build-week/hover-jet/vision/fiducial_board.png

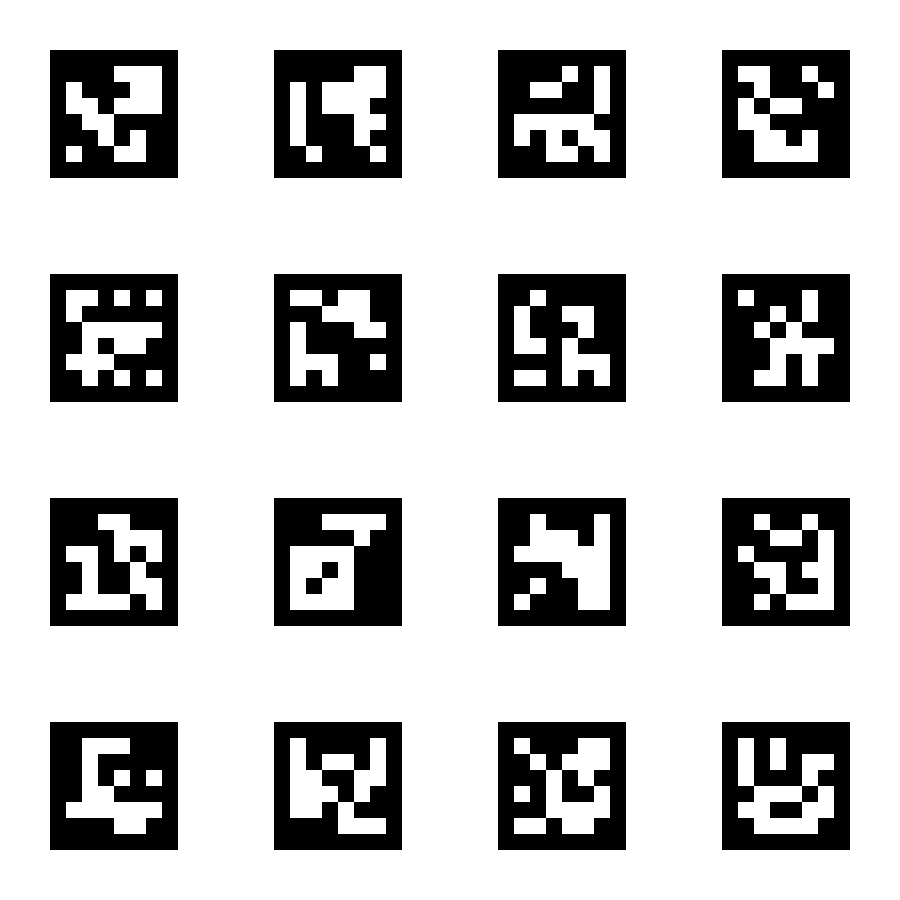
vision/fiducial_board.png
