build-week/hover-jet/hardware/schematics/hoverjet1.5/current_sensor.kicad_sch

## KiCad design hardware/schematics/hoverjet1.5/current_sensor.kicad_sch (2024-02-24)

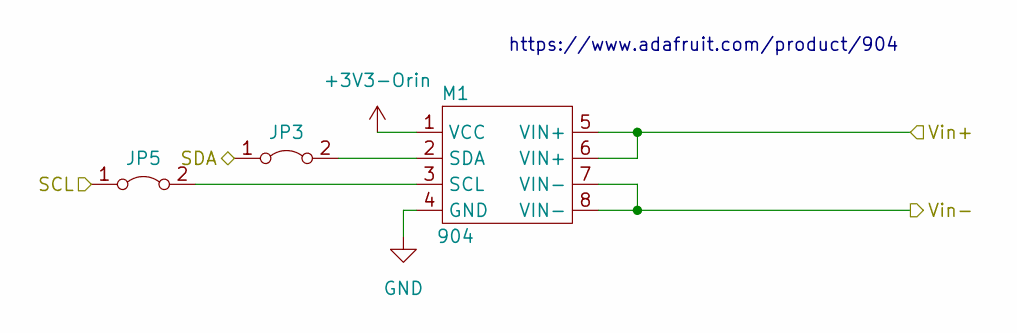
[picture p3: schematic current_sensor.kicad_sch]

Parts:
JP3, JP5: Jumper_2_Bridged; SolderJumper-2_P1.3mm_Bridged_Pad1.0x1.5mm
M1: 904; Manufacturer Part Number 904

Connections:
+3V3-Orin: M1.1 (VCC)
GND: M1.4 (GND)
unnamed: JP3.2 (B), M1.2 (SDA)
unnamed: JP5.2 (B), M1.3 (SCL)
SCL: JP5.1 (A)
SDA: JP3.1 (A)
Vin+: M1.5 (VIN+), M1.6 (VIN+)
Vin-: M1.7 (VIN-), M1.8 (VIN-)

Notes on the sheet:
https://www.adafruit.com/product/904
