build-week/hover-jet/hardware/schematics/hoverjet1.5/hoverjet1.5.kicad_sch

## KiCad design hardware/schematics/hoverjet1.5/hoverjet1.5.kicad_sch (2024-02-24)

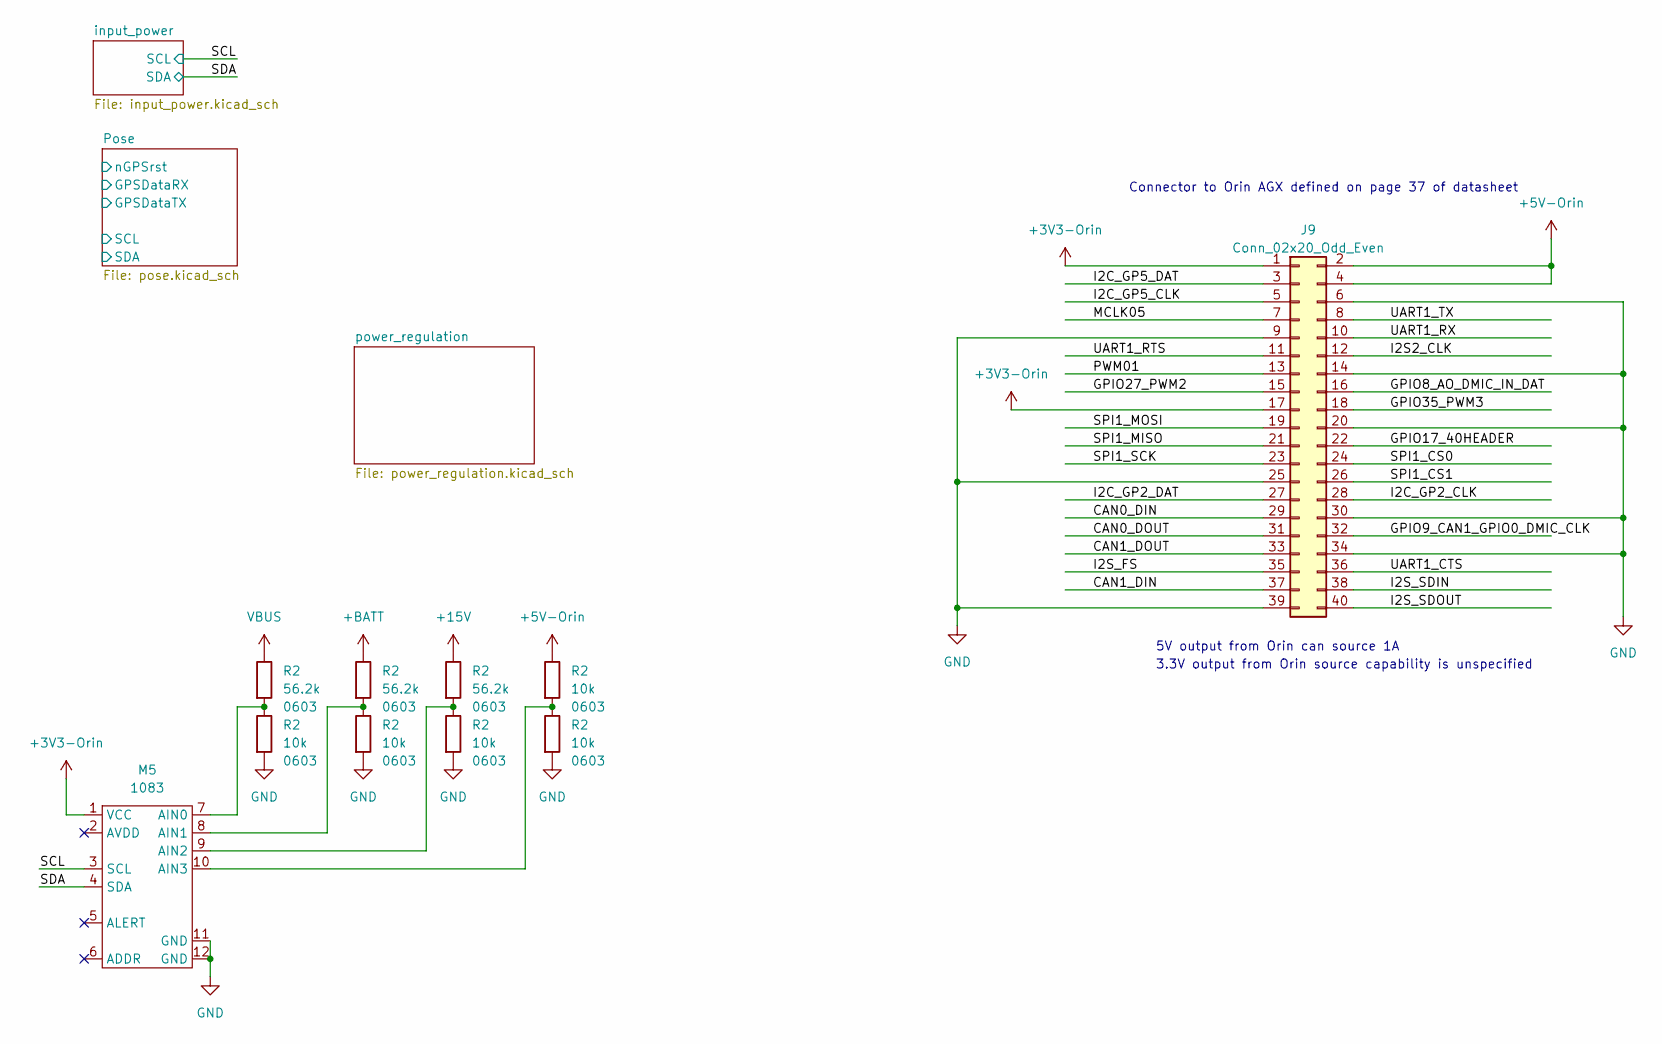
[picture p4: schematic hoverjet1.5.kicad_sch]

Parts:
J9: Conn_02x20_Odd_Even; PinHeader_2x20_P2.54mm_Horizontal
M5: 1083; MPN 1083
R2: 10k; R_0603_1608Metric_Pad0.98x0.95mm_HandSolder; Tolerance 1%; MPN RMCF0603FT10K0

Connections:
+3V3-Orin: J9.1, J9.17, M5.1 (VCC)
+5V-Orin: J9.2, J9.4, R2.1
+15V: R2.1
+BATT: R2.1
CAN0_DIN: J9.29
CAN0_DOUT: J9.31
CAN1_DIN: J9.37
CAN1_DOUT: J9.33
GND: J9.6, J9.9, J9.14, J9.20, J9.25, J9.30, J9.34, J9.39, M5.11 (GND), M5.12 (GND), R2.2
GPIO8_AO_DMIC_IN_DAT: J9.16
GPIO9_CAN1_GPIO0_DMIC_CLK: J9.32
GPIO17_40HEADER: J9.22
GPIO27_PWM2: J9.15
GPIO35_PWM3: J9.18
I2C_GP2_CLK: J9.28
I2C_GP2_DAT: J9.27
I2C_GP5_CLK: J9.5
I2C_GP5_DAT: J9.3
I2S2_CLK: J9.12
I2S_FS: J9.35
I2S_SDIN: J9.38
I2S_SDOUT: J9.40
MCLK05: J9.7
unnamed: M5.7 (AIN0), R2.1, R2.2
unnamed: M5.8 (AIN1), R2.1, R2.2
unnamed: M5.9 (AIN2), R2.1, R2.2
unnamed: M5.10 (AIN3), R2.1, R2.2
PWM01: J9.13
SCL: M5.3 (SCL)
SDA: M5.4 (SDA)
SPI1_CS0: J9.24
SPI1_CS1: J9.26
SPI1_MISO: J9.21
SPI1_MOSI: J9.19
SPI1_SCK: J9.23
UART1_CTS: J9.36
UART1_RTS: J9.11
UART1_RX: J9.10
UART1_TX: J9.8
VBUS: R2.1

Notes on the sheet:
3.3V output from Orin source capability is unspecified
Connector to Orin AGX defined on page 37 of datasheet
5V output from Orin can source 1A
