build-week/hover-jet/hardware/schematics/hoverjet1.5/input_power.kicad_sch

## KiCad design hardware/schematics/hoverjet1.5/input_power.kicad_sch (2023-09-26)

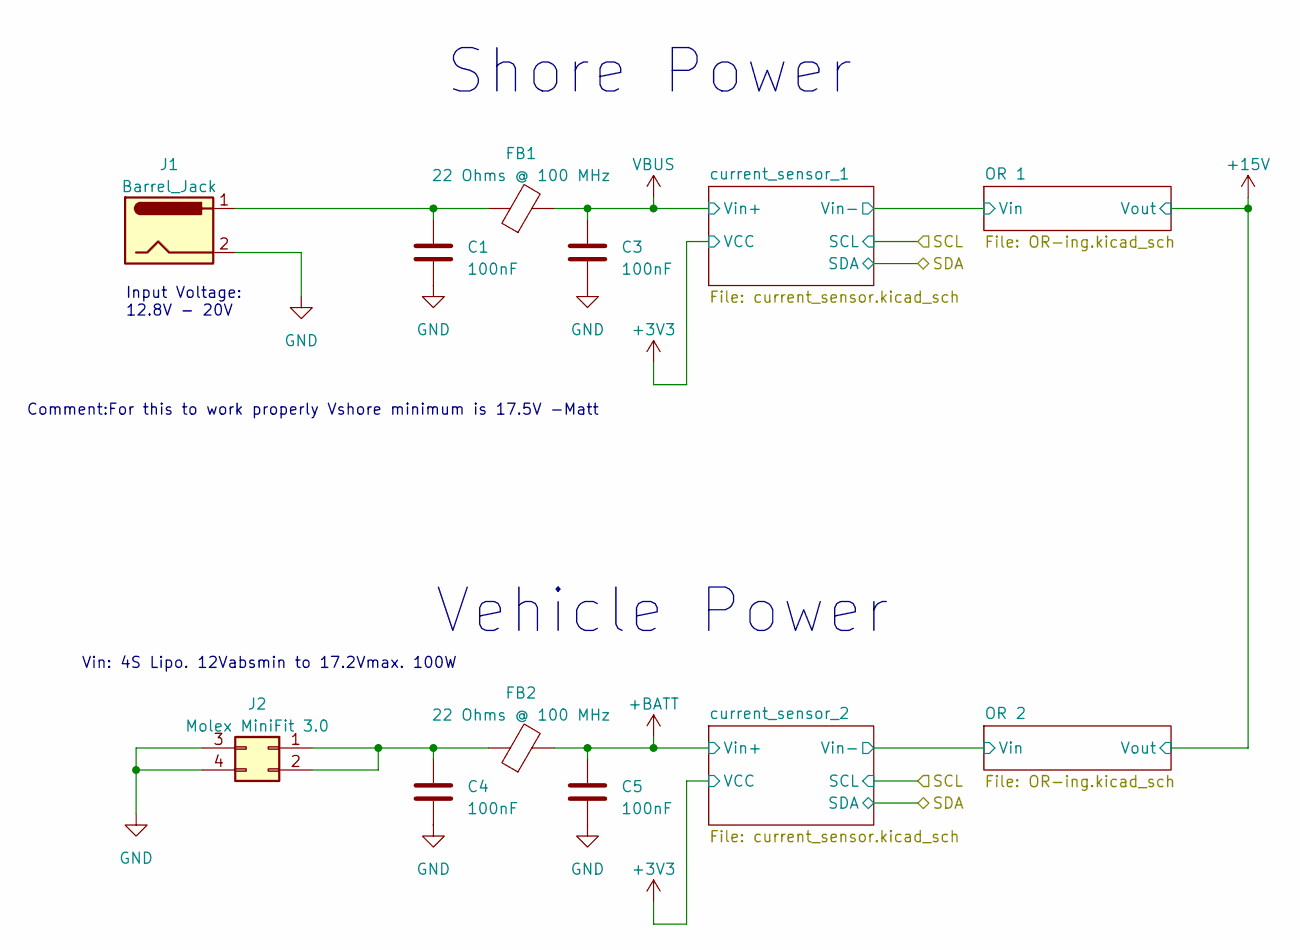
[picture p5: schematic input_power.kicad_sch]

Parts:
C1, C3, C4, C5: 100nF; C_0201_0603Metric
FB1, FB2: 22 Ohms @ 100 MHz; R_0805_2012Metric
J1: Barrel_Jack; BarrelJack_CUI_PJ-063AH_Horizontal
J2: Molex MiniFit 3.0; Molex_Micro-Fit_3.0_43045-0400_2x02_P3.00mm_Horizontal

Connections:
+BATT: C5.1, FB2.2
GND: C1.2, C3.2, C4.2, C5.2, J1.2, J2.3, J2.4
unnamed: C1.1, FB1.1, J1.1
unnamed: C4.1, FB2.1, J2.1, J2.2
VBUS: C3.1, FB1.2

Notes on the sheet:
Input Voltage: 12.8V - 20V
Shore Power
Vehicle Power
Vin: 4S Lipo. 12Vabsmin to 17.2Vmax. 100W
Comment:For this to work properly Vshore minimum is 17.5V -Matt
