build-week/hover-jet/hardware/schematics/hoverjet1.5/pose.kicad_sch

## KiCad design hardware/schematics/hoverjet1.5/pose.kicad_sch (2024-02-24)

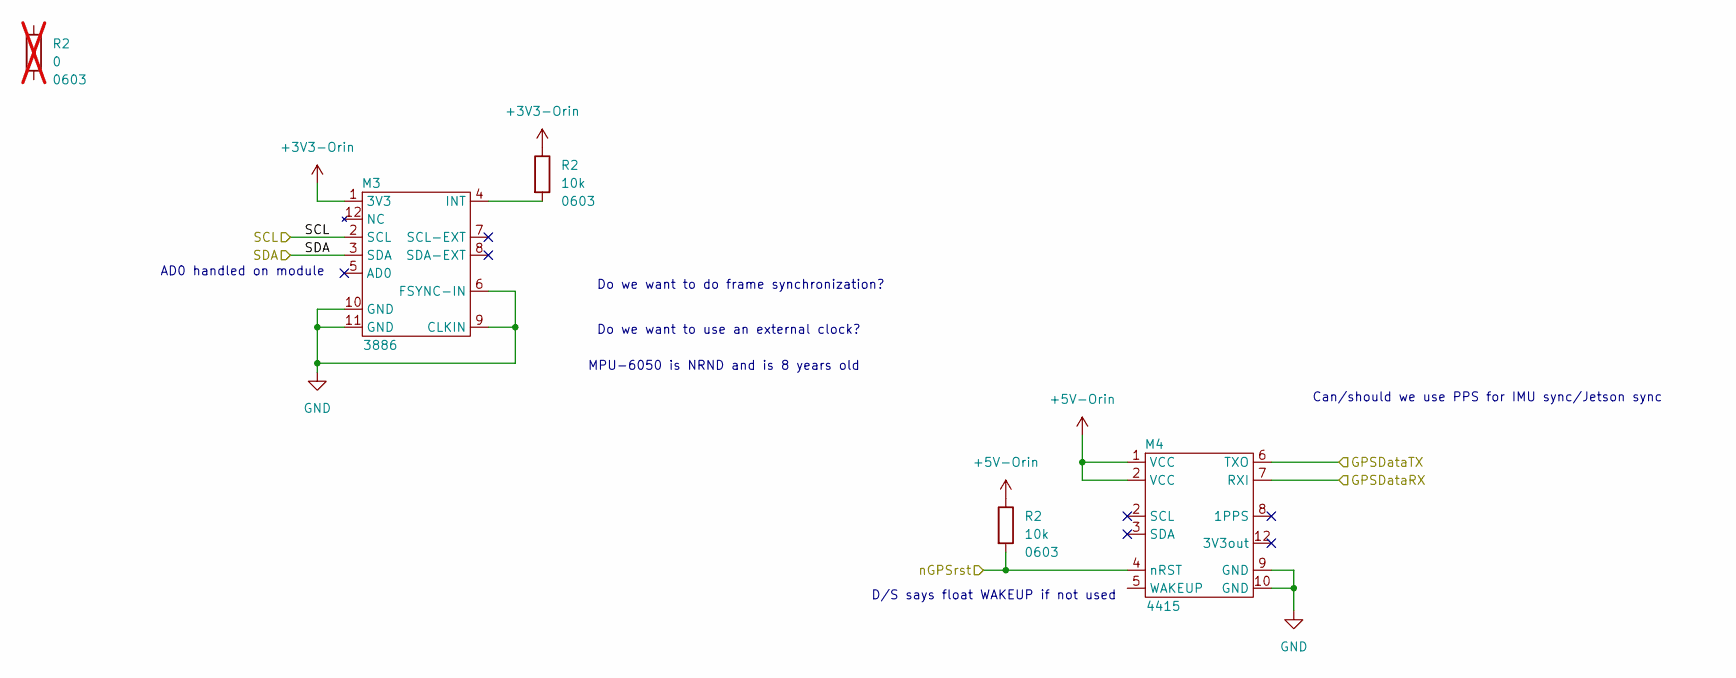
[picture p6: schematic pose.kicad_sch]

Parts:
M3: 3886; Manufacturer Part Number 3886
M4: 4415; MPN 4415
R2: 10k; R_0603_1608Metric_Pad0.98x0.95mm_HandSolder; Tolerance 1%; MPN RMCF0603FT10K0

Connections:
+3V3-Orin: M3.1 (3V3), R2.1
+5V-Orin: M4.1 (VCC), M4.2 (SCL), R2.1
GND: M3.6 (FSYNC-IN), M3.9 (CLKIN), M3.10 (GND), M3.11 (GND), M4.9 (GND), M4.10 (GND)
GPSDataRX: M4.7 (RXI)
GPSDataTX: M4.6 (TXO)
unnamed: M3.4 (INT), R2.2
SCL: M3.2 (SCL)
SDA: M3.3 (SDA)
nGPSrst: M4.4 (nRST), R2.2

Notes on the sheet:
Can/should we use PPS for IMU sync/Jetson sync
D/S says float WAKEUP if not used
Do we want to do frame synchronization?
MPU-6050 is NRND and is 8 years old
AD0 handled on module
Do we want to use an external clock?
