build-week/hover-jet/hardware/schematics/hoverjet1.5/untitled.kicad_sch

## KiCad design hardware/schematics/hoverjet1.5/untitled.kicad_sch (2023-09-26)

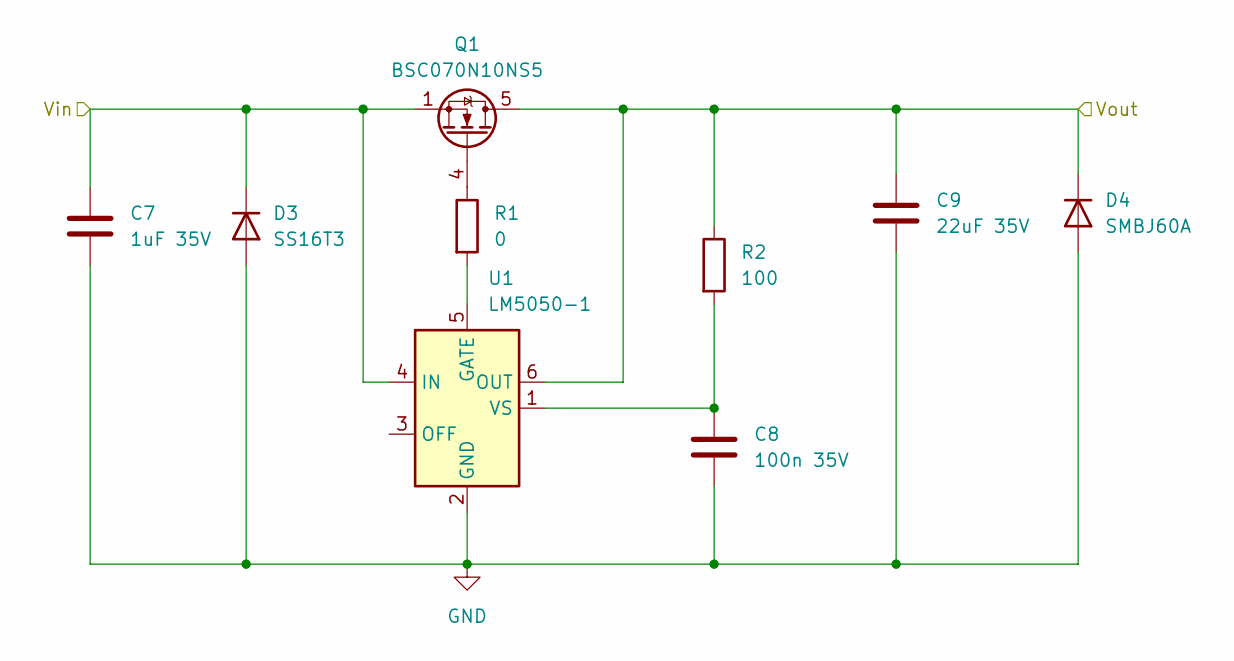
[picture p7: schematic untitled.kicad_sch]

Parts:
C7: 1uF 35V
C8: 100n 35V
C9: 22uF 35V
D3: SS16T3
D4: SMBJ60A
Q1: BSC070N10NS5; TDSON-8-1
R1: 0
R2: 100
U1: LM5050-1; TSOT-23-6

Connections:
GND: C7.2, C8.2, C9.2, D3.2 (A), D4.2 (A), U1.2 (GND)
unnamed: C8.1, R2.2, U1.1 (VS)
unnamed: Q1.4 (G), R1.1
unnamed: R1.2, U1.5 (GATE)
Vin: C7.1, D3.1 (K), Q1.1 (S), Q1.2 (S), Q1.3 (S), U1.4 (IN)
Vout: C9.1, D4.1 (K), Q1.5 (D), R2.1, U1.6 (OUT)
