build-week/hover-jet/filtering/filter_demo.cc

#include <queue>

//%deps(opencv)
#include <opencv2/opencv.hpp>

#include "camera/camera_image_message.hh"
#include "embedded/imu_driver/imu_message.hh"
#include "infrastructure/logging/log_reader.hh"

//%deps(fiducial_pose)
//%deps(rotation_to)
#include "third_party/experiments/estimation/vision/fiducial_pose.hh"
#include "third_party/experiments/geometry/rotation_to.hh"

//%deps(jet_filter)
//%deps(simple_geometry)
//%deps(jet_optimizer)
//%deps(window_3d)
#include "third_party/experiments/estimation/jet/jet_filter.hh"
#include "third_party/experiments/estimation/jet/jet_optimizer.hh"
#include "third_party/experiments/viewer/primitives/simple_geometry.hh"
#include "third_party/experiments/viewer/window_3d.hh"

//%deps(time_interpolator)
#include "third_party/experiments/geometry/spatial/time_interpolator.hh"

//%deps(fit_ellipse)
#include "third_party/experiments/geometry/shapes/fit_ellipse.hh"

//
#include "camera/camera_manager.hh"
#include "vision/fiducial_detection_and_pose.hh"
#include "vision/fiducial_detection_message.hh"

namespace jet {
namespace filtering {
namespace {
// TODO FACTOR
void draw_states(viewer::SimpleGeometry& geo, const std::vector<estimation::jet_filter::State>& states, bool truth) {
  const int n_states = static_cast<int>(states.size());
  for (int k = 0; k < n_states; ++k) {
    auto& state = states.at(k);
    const SE3 T_world_from_body = state.T_body_from_world.inverse();
    if (truth) {
      geo.add_axes({T_world_from_body, 0.1});
    } else {
      geo.add_axes({T_world_from_body, 0.01, 1.0, true});
      if (k < n_states - 1) {
        const auto& next_state = states.at(k + 1);
        const SE3 T_world_from_body_next = next_state.T_body_from_world.inverse();
        geo.add_line({T_world_from_body.translation(), T_world_from_body_next.translation()});
      }
    }
  }
}

void setup() {
  const auto view = viewer::get_window3d("Filter Debug");
  // view->set_azimuth(0.0);
  // view->set_elevation(0.0);
  // view->set_zoom(1.0);
  view->set_target_from_world(SE3(SO3::exp(Eigen::Vector3d(-3.1415 * 0.5, 0.0, 0.0)), jcc::Vec3(-1.0, 0.0, -1.0)));
  view->set_continue_time_ms(10);
  const auto background = view->add_primitive<viewer::SimpleGeometry>();
  const geometry::shapes::Plane ground{jcc::Vec3::UnitZ(), 0.0};
  background->add_plane({ground, 0.1});
  background->flip();
}

estimation::TimePoint to_time_point(const Timestamp& ts) {
  const auto epoch_offset = std::chrono::nanoseconds(uint64_t(ts));
  const estimation::TimePoint time_point = estimation::TimePoint{} + epoch_offset;
  return time_point;
}

class Calibrator {
 public:
  Calibrator() {
    const auto view = viewer::get_window3d("Filter Debug");
    geo_ = view->add_primitive<viewer::SimpleGeometry>();
  }

  void maybe_add_imu(const ImuMessage& msg) {
    const auto time_of_validity = to_time_point(msg.timestamp);
    if (estimation::to_seconds(time_of_validity - earliest_camera_time_) > 25.0) {
      return;
    }
    // if (timestamp > earliest_camera_time_) {
    if (true) {
      // std::cout << "Accel:"  << uint64_t(msg.timestamp) << std::endl;
      const jcc::Vec3 accel_mpss(msg.accel_mpss_x, msg.accel_mpss_y, msg.accel_mpss_z);

      estimation::jet_filter::AccelMeasurement accel_meas;
      accel_meas.observed_acceleration = accel_mpss;
      accel_meas_.push_back({accel_meas, time_of_validity});

      const jcc::Vec3 gyro_radps(msg.gyro_radps_x, msg.gyro_radps_y, msg.gyro_radps_z);
      estimation::jet_filter::GyroMeasurement gyro_meas;
      gyro_meas.observed_w = gyro_radps;
      gyro_meas_.push_back({gyro_meas, time_of_validity + estimation::to_duration(0.000001)});

      const jcc::Vec3 mag_utesla(msg.mag_utesla_x, msg.mag_utesla_y, msg.mag_utesla_z);
      mag_utesla_.push_back({mag_utesla, time_of_validity});
      geo_->add_point({(mag_utesla)});
      geo_->flush();
    }
    // Otherwise, ignore it
  }

  void add_fiducial(const Timestamp& ts, const SE3& world_from_camera) {
    const auto time_of_validity = to_time_point(ts);
    if (!got_camera_) {
      auto xp0 = estimation::jet_filter::JetFilter::reasonable_initial_state();

      xp0.x.T_body_from_world = world_from_camera.inverse();
      xp0.time_of_validity = time_of_validity;
      jf_.reset(xp0);

      earliest_camera_time_ = time_of_validity;
    }
    // std::cout << "cam: " << uint64_t(ts) << std::endl;
    if (estimation::to_seconds(time_of_validity - earliest_camera_time_) > 25.0) {
      return;
    }

    got_camera_ = true;

    estimation::jet_filter::FiducialMeasurement fiducial_meas;
    fiducial_meas.T_fiducial_from_camera = world_from_camera;

    // jf_.measure_fiducial(fiducial_meas, time_of_validity);
    // jet_opt_.measure_fiducial(fiducial_meas, time_of_validity);
    fiducial_meas_.push_back({fiducial_meas, time_of_validity});

    geo_->add_axes({world_from_camera, 0.025, 3.0});

    const auto view = viewer::get_window3d("Filter Debug");

    geo_->flush();
  }

  geometry::spatial::TimeInterpolator fit_mag() const {
    std::vector<jcc::Vec3> measurements;
    const auto view = viewer::get_window3d("Filter Debug");
    for (const auto& pt : mag_utesla_) {
      measurements.push_back(pt.first);
    }

    const auto ell_geo = view->add_primitive<viewer::SimpleGeometry>();
    const auto visitor = [&ell_geo, &view](const geometry::shapes::EllipseFit& fit) {
      ell_geo->add_ellipsoid({fit.ellipse, jcc::Vec4(0.4, 0.6, 0.4, 0.7), 2.0});
      ell_geo->flip();
    };
    const auto result = geometry::shapes::fit_ellipse(measurements, visitor);

    ell_geo->add_ellipsoid({result.ellipse, jcc::Vec4(0.2, 1.0, 0.2, 1.0), 4.0});
    ell_geo->flip();
    view->spin_until_step();

    std::vector<geometry::spatial::TimeControlPoint> control_points;
    for (const auto& pt : mag_utesla_) {
      const auto pt_time = pt.second;

      const jcc::Vec3 pt_mag_utesla = pt.first;

      const jcc::Vec3 pt_mag_corrected =
          (result.ellipse.cholesky_factor.transpose().inverse() * (pt_mag_utesla - result.ellipse.p0));

      ell_geo->add_point({pt_mag_corrected, jcc::Vec4(1.0, 0.2, 0.3, 1.0)});

      control_points.push_back({pt_time, pt_mag_corrected});
    }

    ell_geo->flip();

    const geometry::spatial::TimeInterpolator interpolator(control_points);
    return interpolator;
  }

  geometry::spatial::TimeInterpolator make_accel_interpolator() const {
    std::vector<geometry::spatial::TimeControlPoint> points;
    for (const auto& measurement : accel_meas_) {
      points.push_back({measurement.second, measurement.first.observed_acceleration});
    }
    const geometry::spatial::TimeInterpolator interp(points);
    return interp;
  }

  geometry::spatial::TimeInterpolator make_gyro_interpolator() const {
    std::vector<geometry::spatial::TimeControlPoint> points;
    for (const auto& measurement : gyro_meas_) {
      points.push_back({measurement.second, measurement.first.observed_w});
    }
    const geometry::spatial::TimeInterpolator interp(points);
    return interp;
  }

  void prepare() {
    const auto view = viewer::get_window3d("Filter Debug");

    const auto mag_interpolator = fit_mag();
    const auto accel_interpolator = make_accel_interpolator();

    const SE3 imu_from_vehicle = jf_.parameters().T_imu_from_vehicle;

    for (const auto& fiducial_meas : fiducial_meas_) {
      const SE3 world_from_vehicle = fiducial_meas.first.T_fiducial_from_camera;
      const SE3 imu_from_world = imu_from_vehicle * world_from_vehicle.inverse();

      // geo_->add_axes({imu_from_world.inverse(), 0.01});

      const auto fiducial_measurement_t = fiducial_meas.second;

      const auto maybe_interp_at_t = accel_interpolator(fiducial_measurement_t);
      if (!maybe_interp_at_t) {
        std::cout << "Failed" << std::endl;
        continue;
      }
      const jcc::Vec3 accel_meas_imu_at_t = *maybe_interp_at_t;
      const jcc::Vec3 accel_meas_vehicle_frame = imu_from_vehicle.so3().inverse() * accel_meas_imu_at_t;

      const jcc::Vec3 mag_meas_vehicle_frame = imu_from_vehicle.so3() * (*mag_interpolator(fiducial_measurement_t));

      constexpr double M_PER_MPSS = 0.01;
      const jcc::Vec4 imu_obs_color(0.1, 0.7, 0.7, 0.4);
      geo_->add_line({world_from_vehicle.translation(), world_from_vehicle * (accel_meas_vehicle_frame * M_PER_MPSS),
                      imu_obs_color});

      /*
      const jcc::Vec3 g_vehicle_frame = (world_from_vehicle.so3().inverse() * (jcc::Vec3::UnitZ() * 9.81));
      const jcc::Vec3 accel_g_subtracted_vehicle = accel_meas_vehicle_frame - g_vehicle_frame;
      const jcc::Vec3 imu_direction = world_from_vehicle.so3() * (accel_g_subtracted_vehicle).normalized();
      const double accel_norm_no_g = accel_g_subtracted_vehicle.norm() * M_PER_MPSS;
      geo_->add_ray({world_from_vehicle.translation(), imu_direction, accel_norm_no_g, imu_obs_color, 3.0});
      */

      const jcc::Vec4 mag_obs_color(1.0, 0.3, 0.3, 0.4);
      geo_->add_ray({world_from_vehicle.translation(), world_from_vehicle.so3() * mag_meas_vehicle_frame.normalized(),
                     1.0, mag_obs_color, 3.0});

      const double cos_angle_grav_bfield =
          accel_meas_vehicle_frame.normalized().dot(mag_meas_vehicle_frame.normalized());

      // geo_->add_ray(
      // {jcc::Vec3::Zero(), world_from_vehicle.so3() * mag_meas_vehicle_frame.normalized(), 1.0, mag_obs_color, 3.0});
    }
    view->spin_until_step();
    geo_->flush();
  }

  std::vector<estimation::jet_filter::State> test_filter() {
    const auto view = viewer::get_window3d("Filter Debug");
    const auto accel_interpolator = make_accel_interpolator();
    const auto gyro_interpolator = make_gyro_interpolator();

    const SE3 imu_from_vehicle = jf_.parameters().T_imu_from_vehicle;

    std::vector<estimation::jet_filter::State> est_states;
    geo_->clear();

    const auto first_t = fiducial_meas_.front().second;
    for (const auto& fiducial_meas : fiducial_meas_) {
      const estimation::TimePoint t = fiducial_meas.second;
      if (t < first_t + estimation::to_duration(0.5)) {
        continue;
      }
      jf_.measure_fiducial(fiducial_meas.first, t);
      jet_opt_.measure_fiducial(fiducial_meas.first, t);

      std::cout << "Camera Location: " << fiducial_meas.first.T_fiducial_from_camera.translation().transpose()
                << std::endl;

      geo_->add_axes({fiducial_meas.first.T_fiducial_from_camera, 0.001, 3.0});
    }

    for (const auto& accel_meas : accel_meas_) {
      const estimation::TimePoint t = accel_meas.second;
      if (t <= (first_t + estimation::to_duration(3.0))) {
        std::cout << "Skipping" << std::endl;
        continue;
      }
      // jf_.measure_imu(accel_meas.first, t);
      // jet_opt_.measure_imu(accel_meas.first, t);
    }

    estimation::TimePoint prev_time;

    while (true) {
      std::cout << "\n" << std::endl;
      const auto maybe_state = jf_.next_measurement();
      if (!maybe_state) {
        break;
      }

      const auto state = jf_.state().x;
      est_states.push_back(state);

      const auto cov = jf_.state().P;
      const Eigen::LLT<MatNd<3, 3>> P_llt(
          cov.block<3, 3>(estimation::jet_filter::StateDelta::T_body_from_world_error_log_ind,
                          estimation::jet_filter::StateDelta::T_body_from_world_error_log_ind));

      const auto t = jf_.state().time_of_validity;

      std::cout << "dt: " << estimation::to_seconds(t - prev_time) << std::endl;
      prev_time = t;

      const SE3 T_world_from_body = state.T_body_from_world.inverse();

      constexpr double M_PER_MPSS = 0.01;

      const jcc::Vec3 meas_accel_imu_t = *accel_interpolator(t);
      const jcc::Vec3 expected_accel_imu = observe_accel(state, jf_.parameters()).observed_acceleration;

      const jcc::Vec3 meas_gyro_imu_t = *gyro_interpolator(t);
      const jcc::Vec3 expected_gyro_imu = observe_gyro(state, jf_.parameters()).observed_w;
      /*
            geo_->add_line({T_world_from_body.translation(), T_world_from_body * (meas_accel_imu_t * M_PER_MPSS),
                            jcc::Vec4(1.0, 0.0, 0.0, 0.8)});

            geo_->add_line({T_world_from_body.translation(), T_world_from_body * (expected_accel_imu * M_PER_MPSS),
                            jcc::Vec4(0.0, 1.0, 0.0, 0.8)});
      */
      const jcc::Vec3 g_world = jcc::Vec3::UnitZ() * 9.81;
      const jcc::Vec3 g_vehicle_frame = (T_world_from_body.so3().inverse() * g_world);

      // const jcc::Vec3 accel_g_subtracted_vehicle = meas_accel_imu_t - g_vehicle_frame;
      const jcc::Vec3 g_imu = imu_from_vehicle.so3() * T_world_from_body.so3().inverse() * g_world;

      std::cout << "\n" << std::endl;
      // std::cout << "g_body:" << g_vehicle_frame.transpose() << std::endl;
      std::cout << "g_imu:      " << g_imu.transpose() << std::endl;
      // std::cout << "accel     : " << accel_g_subtracted_vehicle.transpose() << std::endl;
      std::cout << "meas accel: " << meas_accel_imu_t.transpose() << std::endl;
      std::cout << "exp accel:  " << expected_accel_imu.transpose() << std::endl;

      std::cout << "meas sp f: " << (meas_accel_imu_t - g_imu).transpose() << std::endl;
      std::cout << "exp sp f: " << (expected_accel_imu - g_imu).transpose() << std::endl;

      std::cout << "meas gyro:  " << meas_gyro_imu_t.transpose() << std::endl;
      std::cout << "exp gyro:   " << expected_gyro_imu.transpose() << std::endl;

      std::cout << "accel_bias: " << state.accel_bias.transpose() << std::endl;
      std::cout << "eps_ddot:   " << state.eps_ddot.transpose() << std::endl;
      std::cout << "eps_dot:    " << state.eps_dot.transpose() << std::endl;

      geo_->add_axes({T_world_from_body, 0.01, 1.0, true});
      geo_->add_ellipsoid({geometry::shapes::Ellipse{P_llt.matrixU(), T_world_from_body.translation()}});

      geo_->flush();
      view->spin_until_step();
    }
    return est_states;
  }

  void run() {
    prepare();
    const std::vector<estimation::jet_filter::State> est_states = test_filter();

    const auto view = viewer::get_window3d("Filter Debug");

    std::cout << "Calibrating" << std::endl;
    const auto visitor = make_visitor();
    const auto solution = jet_opt_.solve(est_states, jf_.parameters(), visitor);
  }

 private:
  estimation::jet_filter::JetPoseOptimizer::Visitor make_visitor() {
    const auto view = viewer::get_window3d("Filter Debug");
    const auto visitor_geo = view->add_primitive<viewer::SimpleGeometry>();
    const auto visitor = [view, visitor_geo](const estimation::jet_filter::JetPoseOptimizer::Solution& soln) {
      visitor_geo->clear();
      draw_states(*visitor_geo, soln.x, false);
      visitor_geo->flip();
      // std::cout << "\tOptimized g: " << soln.p.g_world.transpose() << std::endl;
      std::cout << "\tOptimized T_imu_from_vehicle: " << soln.p.T_imu_from_vehicle.translation().transpose() << "; "
                << soln.p.T_imu_from_vehicle.so3().log().transpose() << std::endl;
      view->spin_until_step();
    };
    return visitor;
  }

  estimation::TimePoint earliest_camera_time_ = estimation::TimePoint::max();
  bool got_camera_ = false;

  std::vector<std::pair<estimation::jet_filter::AccelMeasurement, estimation::TimePoint>> accel_meas_;
  std::vector<std::pair<estimation::jet_filter::FiducialMeasurement, estimation::TimePoint>> fiducial_meas_;
  std::vector<std::pair<estimation::jet_filter::GyroMeasurement, estimation::TimePoint>> gyro_meas_;

  std::vector<std::pair<jcc::Vec3, estimation::TimePoint>> mag_utesla_;

  estimation::jet_filter::JetFilter jf_;
  estimation::jet_filter::JetOptimizer jet_opt_;

  // temp
  std::shared_ptr<viewer::SimpleGeometry> geo_;
};

}  // namespace

void go() {
  setup();
  CameraManager camera_manager_ = CameraManager();
  const auto view = viewer::get_window3d("Filter Debug");
  const auto geo = view->add_primitive<viewer::SimpleGeometry>();
  const std::vector<std::string> channel_names = {"imu", "fiducial_detection_channel", "camera_image_channel"};

  // const std::string path = "/jet/logs/calibration-log-jan26-1";
  const std::string path = "/jet/logs/calibration-log-jan31-1";
  // const std::string path = "/jet/logs/calibration-log-feb9-1";
  // const std::string path = "/jet/logs/calibration-log-feb9-2";

  Calibrator calibrator;
  jet::LogReader reader(path, channel_names);

  bool accepted_any = false;
  SE3 last_world_from_camera;

  constexpr bool USE_CAMERA_IMAGES = false;
  constexpr bool USE_FIDUCIAL_DETECTIONS = true;

  int imu_ct = 0;
  for (int k = 0; k < 3000; ++k) {
    {
      ImuMessage imu_msg;
      if (reader.read_next_message("imu", imu_msg)) {
        imu_ct++;
        // if (imu_ct % 1 == 0) {
        if (imu_ct) {
          calibrator.maybe_add_imu(imu_msg);
        }
      } else {
        std::cout << "Breaking at : " << k << std::endl;
        break;
      }
    }

    /*
    if (USE_CAMERA_IMAGES) {
      CameraImageMessage cam_msg;
      if (reader.read_next_message("camera_image_channel", cam_msg)) {
        Calibration camera_calibration = camera_manager_.get_camera(cam_msg.camera_serial_number).calibration;
        const auto image = get_image_mat(cam_msg);

        const auto result =
            estimate_board_center_from_camera_from_image(get_ids_and_corners(image), camera_calibration);
        if (result) {
          const SE3 world_from_camera = *result;

          if (accepted_any) {
            const SE3 camera_from_last_camera = world_from_camera.inverse() * last_world_from_camera;
            constexpr double MAX_OUTLIER_DIST_M = 0.7;
            if (camera_from_last_camera.translation().norm() > MAX_OUTLIER_DIST_M) {
              continue;
            }
          }

          accepted_any = true;
          last_world_from_camera = world_from_camera;

          calibrator.add_fiducial(cam_msg.timestamp, world_from_camera);
        }
      }
    }
    */

    if (USE_FIDUCIAL_DETECTIONS) {
      FiducialDetectionMessage fiducial_msg;
      if (reader.read_next_message("fiducial_detection_channel", fiducial_msg)) {
        const SE3 world_from_camera = fiducial_msg.fiducial_from_camera();

        // if (accepted_any) {
        //   const SE3 camera_from_last_camera = world_from_camera.inverse() * last_world_from_camera;
        //   constexpr double MAX_OUTLIER_DIST_M = 0.7;
        //   if (camera_from_last_camera.translation().norm() > MAX_OUTLIER_DIST_M) {
        //     continue;
        //   }
        // }

        calibrator.add_fiducial(fiducial_msg.timestamp, world_from_camera);
        accepted_any = true;
        last_world_from_camera = world_from_camera;
      }
    }
    // cv::imshow("Image", image);
    // cv::waitKey(0);
  }

  geo->flush();
  view->spin_until_step();
  std::cout << "Done, preparing to calibrate" << std::endl;

  calibrator.run();
  view->spin_until_step();
}

}  // namespace filtering
}  // namespace jet

int main() {
  jet::filtering::go();
}
