build-week/hover-jet/(commit log)

2018-12-15 added servo driver files
2018-12-17 renamed stuff for proper capitalization, moved driver init in test class inside main, moved constants from header to .cc file, changed header guard to #pragma once
2018-12-22 moved i2c files into third party folder, updated CMakeLists to compile at new location and get rid of redundant lib in filenames
2018-12-22 updated for jakes comments - removed print statements, removed commented code, change prescale calcs to seq of consts, used std::floor, added i2c MIT license, moved some include statements to .cc file
2018-12-23 Feature/imu (#3)
    Add IMU Driver
2018-12-29 Add servo calibration routine (#9)
    Add servo calibration routine
    [servo_cfg0.yaml, servo_cfg1.yaml, servo_cfg2.yaml, servo_cfg3.yaml]
2018-12-29 Add current sensor (#14)
    Adds the current sensor
2018-12-29 Fix pwm test
2018-12-30 If /dev/video0 exists, jet run will mount it in the container automatically
2019-01-01 add camera balsaq
2019-01-01 improve camera BQ speed
2019-01-01 update camera BQ to publish for vision tasks
2019-01-01 camera message
2019-01-06 Clang-format + share i2c + servos and currents at the same time (#26)
    * Fix const string warning
    * Run clang-format
    * Allow current sensor and servos to run together
    - Take in an i2c file handle instead of a file path
    - Change servo_calibrate so that both are running at the same time
    - misc: Rename some cfg files in servo_test
    [ina219_test.cc, pwm_driver.cc, pwm_test.cc, servo_calibrate.cc, servo_driver.cc, servo_test.cc]
2019-01-06 Add timestamps to camera message (#35)
    * Add timestamps to camera message
    * Address Isaac's comment
2019-01-06 calibration + subpix corners
2019-01-06 new calibration
2019-01-07 jet run now mounts logs in container
2019-01-08 basic servo bq implemented and building but not tested
2019-01-09 Add IMU BQ (#31)
2019-01-10 commit servo bq code
2019-01-10 update imu bq
2019-01-10 Aruco boards with SE3 fiducial_from_camera output (#41)
2019-01-12 Add magnetometer measurements to IMU balsaq (#43)
    * Add magnetometer measurements to IMU balsaq
    * Add to message serialization
    * Add high-accuracy mag config
2019-01-12 make servo bq work for multiple servos
2019-01-12 two servos working
2019-01-13 make single message for all servos
2019-01-13 Add tool for commanding servo sweeps (#54)
    * Add servo test utility
    * Add script for generating test sequences
    * Remove pragma from source file
    * Address Isaac's comments
    * Update generate test seq
2019-01-13 Add test visualizer (Vane component) (#56)
    * Additions for thrust stand viz
    * Add visualization and bq
    * Working visualizer; store viewer ptr in bq
    * Color vane-0 red
    * Advance experiments to have exp_z
2019-01-13 JetCat Interface (#53)
    * jet run now mounts logs in container
    * Adding initial implementation of jetcat turbine class. No serial lib yet
    * It works
    * Adding messages
    * Integrating pub/sub into turbine interface bq
    * Removing extra call to stop turbine
    * Adding start / stop scripts
    * Cleaning up
    * Switching to libserialport
    * Adding some error checking
2019-01-17 Load-cell serial and balsaq (#58)
    * basic force sensor bq + message
    * clean up code, prepare for Ralph's additions
    * [Load Cells] Add initial driver support
    * Get load-cell running
    * BQ in usable state
    * Remove dead code
    * Add Arduino code
    * Fix serial snaffu in load cell sketch
    [load_cells.ino]
2019-01-17 Update servo tests to use max range (#63)
2019-01-18 Add vane force/torque model (#51)
    * Add wrench model
    - Includes vane-unit force/torque models
    - Wrench; with a frame-transform method
    - Quadraframe force/torque model
    - A simple playground to mess with these things
    - A test
    * Add mechanism for computing mappings
    * Delete or explain commented code
    * Remove commented code
    * Apply suggestions from code review
    * Address Review
    TODO(jake): Add CAD
    * Address review comments and add readme
    * Fix compilation errors
    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
    [jet_vane_mapper.cc, jet_vane_mapper_test.cc, jet_vane_model.cc, jet_vane_model_test.cc, quadraframe_model.cc, thrust_stand_visualization_bq.cc, thrust_stand_visualizer.cc]
2019-01-18 Can now command thrust % or RPM (#65)
2019-01-19 Add force sensor visualization (#67)
    * Add force sensor visualization
    * Clarify printouts as intentional
    * Remove comments
2019-01-19 Remove prints from loadcells
2019-01-19 set FPS of camera
2019-01-25 Logger now logs to /log mount and has shorter sleep. (#72)
2019-01-26 [Load Cell] Remove serial flow-control
2019-01-26 added print statments to timesync client bq including offset between client and master
2019-01-26 added timesync master to supervisor conf; created new thrust_stand conf
2019-01-28 Make fiducial detection code match the printed fiducial (#78)
    * Fiducial detection looks good
    * fix compile
2019-01-29 Pin docker version in jet_run, jet_* (#81)
    * Pin docker version
    * Add jet functions
    * Update
2019-02-09 added last_msg timestamp to BQs, added gonogo timeouts to camera and fiducial balsaqs
2019-02-09 added new constructors to duration, updated usage in camera and fiducial balsaqs
2019-02-09 added gonogo to imu driver & balsaq
2019-02-09 added printout in gonogo for testing
2019-02-09 added gonogo to servo bq, added braces to imu bq
2019-02-10 basic configs for camera extrinsincs and fiducial pose
2019-02-10 Adding additional joystick control for pitch, roll, and yaw using stick + pedals
2019-02-10 Implement filter, controller, add supervisorconf for both (#95)
    * Jet Localization Filter
    * its good
    * Ready to go
    * Everything is working
2019-02-14 servo 2 died - swapped and recalibrated
    [servo_cfg2.yaml]
2019-03-25 Servo Shutdown (#102)
    * added sleep method to pwm driver, shutdown method to servo driver, and shutdown call to servo balsaq on shutdown
    * fixed typo in servo driver; updated servo calibrate with correct config paths
    * renamed sleep to more clear disable_servos
    [pwm_driver.cc, servo_balsaq.cc, servo_calibrate.cc, servo_driver.cc]
2019-03-28 include board point to image point association in fiducial message
2019-03-30 Allow weighted force in thrust mapper (#111)
    * Allow differentially weighted force
    * Jet vane mapper fix
    * Add pose simulation bq
    * Fix compile failure
    * Decrease weight through more
    [controller_balsaq.cc, jet_vane_mapper.cc, jet_vane_mapper_test.cc]
2019-03-30 Make gonogo only print out on state changes (#110)
    * Make gonogo only print out on state changes
    * fix
    * added conditional print for nogo->go state changes
2019-04-05 Adding yaml configs where needed
    [servo_configs.yaml]
2019-04-22 Add camera calibration manager (#85)
    * WIP - added camera calibration manager
    * WIP - changed to camera manager; changed to static method for getting camera info; added symlink following
    * changed camera manager to take in serial number, added camera manager usage to fiducial detection
    * fixed typo on camera balsaq argv number
    * fixed bug in cv matrix copying
    * changed camera manager to require a stored instance and not read from disk on each call
    * updated supervisor to launch camera balsaq with serial of jet camera
    * WIP - added camera calibration manager
    * WIP - changed to camera manager; changed to static method for getting camera info; added symlink following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
    [filter_demo.cc]
2019-04-27 Unpin arm image (#116)
2019-04-27 create camera viewer bq (#114)
    Create camera viewer bq
2019-04-30 Change gonogo state transition printout (#122)
    * Gonogo message change
2019-04-30 Print out *current* status (#123)
2019-04-30 Update camera bq to use config (#119)
    * Update camera bq to use config
    * Add camera yaml
    * Remove dead names, log the camera output
2019-06-01 Bugfix/imu initialization (#131)
    * Fix IMU Initializtion Bug
    * Fix Typos
    * Move to member function
    [imu_driver.cc]
2019-06-30 Fixes to camera management (#133)
    * fixes
    * address comments
    * remove prints
    * remove prints
    * report serial number
    * rename config field
    * rename config field but correctly
2019-06-30 Support multiple IMU's (#136)
    * Add 2-IMU capability
    * IMU demo
    * Make IMU balsaq complain if guids mismatch
    * Address Mason's comments
2019-07-01 Make camera calibration accessible when camera is not present (#135)
    * Make accessible
    * Renames and tests
    * Address Isaac comments, fix build problem
    [filter_demo.cc]
2019-07-01 Add new IDs for IMUs
2019-07-02 Update timestamp to support camera use case
2019-07-03 Remove duplicated image processing in fiducial BQ (#144)
    We were previously processing each image from scratch twice -- once to get the board pose and another time to get raw points. Now we reuse the processed corner locations and IDs.
2019-07-04 refactor camera BQ
2019-07-04 Get all IMU Readings at Once (#147)
    * Update IMU driver to read all values at once
    * Fix Whitespace
    * Fix Jake Comments
    * Fix Compilation Errors
    [imu_balsaq.cc, imu_driver.cc]
2019-07-04 IMU Speed Fixes (#148)
    * Fix delays in IMU execution loop
    * Update delay to work properly without driver modification
    * Move gating for gonogo publish to inside gonogo
    * Fix ordering error
    [imu_balsaq.cc]
2019-07-04 Fix IMU Data Ordering and Conversion (#150)
2019-07-04 integrated camera-vision BQ
2019-07-04 print time to detect markers
2019-07-05 Add ordering to supervisor to start IMUs first
2019-07-07 Update Balsaq Frequencies and Camera Resolution
2019-07-07 Switch to freq settings in init functions
2019-07-10 Rewrite Servo Driver
    [servo_configs.yaml]
2019-07-10 Add pwm to comment
2019-07-10 Finish calibrations
    [servo_configs.yaml]
2019-07-10 Add publisher for commanded PWM set points
2019-07-11 Fix Servo Test Target
    [servo_test.cc]
2019-07-14 Update camera resolution (#158)
2019-07-27 Update log summarizer to correctly print
2023-09-26 Add hardware files
    [current_sensor.kicad_sch, hoverjet1.5.kicad_pcb, hoverjet1.5.kicad_sch, input_power.kicad_sch, power_regulation.kicad_sch]
2023-09-26 Added LM5050 ideal diode controller
    [OR-ing.kicad_sch, input_power.kicad_sch, untitled.kicad_sch]
2023-09-26 added part numbers, manufacturers, and relevant parameters to OR-ing sheet components
    [OR-ing.kicad_sch]
2023-11-11 added adafruit current sense breakout
    [current_sensor.kicad_sch, hoverjet1.5.kicad_sch]
2024-02-24 syncing hardware changes
    [OR-ing.kicad_sch, current_sensor.kicad_sch, hoverjet1.5.kicad_pcb, hoverjet1.5.kicad_sch, input_power.kicad_sch, pose.kicad_sch, power_regulation.kicad_sch, untitled.kicad_sch]
